madcatse/xt-cf-ide/(list of files, drawings)

Other design files:
KiCad/freerouting.dsn
