madcatse/xt-cf-ide/(commit log)

2024-08-11 Prtoject cleanup
    Convert to Kicad7, 10K resistor removed, symbols and footprints moved to local lib, overall cleanup
    [xt-cf.brd, xt-cf.kicad_pcb, xt-cf.kicad_sch, xt-cf.sch]
2024-08-11 BOM generated
    [freerouting.dsn]
2026-04-29 Little fix
    [xt-cf.kicad_pcb, xt-cf.kicad_sch]
