madcatse/xt-cf-ide/(notices)

Notices in the files:
KiCad/xt-cf.kicad_pcb:
XT-CF-Lite Version 4.1 Copyright (C) 2012-2013
KiCad/xt-cf.kicad_sch:
Sergey's XT (C) 2010 Sergey Kiselev, GNU Free Documentation License (GFDL)
